EmbedDevIOT/BeekeeperIOT_FreeRTOS/docs/models/images/IMG20220707154456.jpg

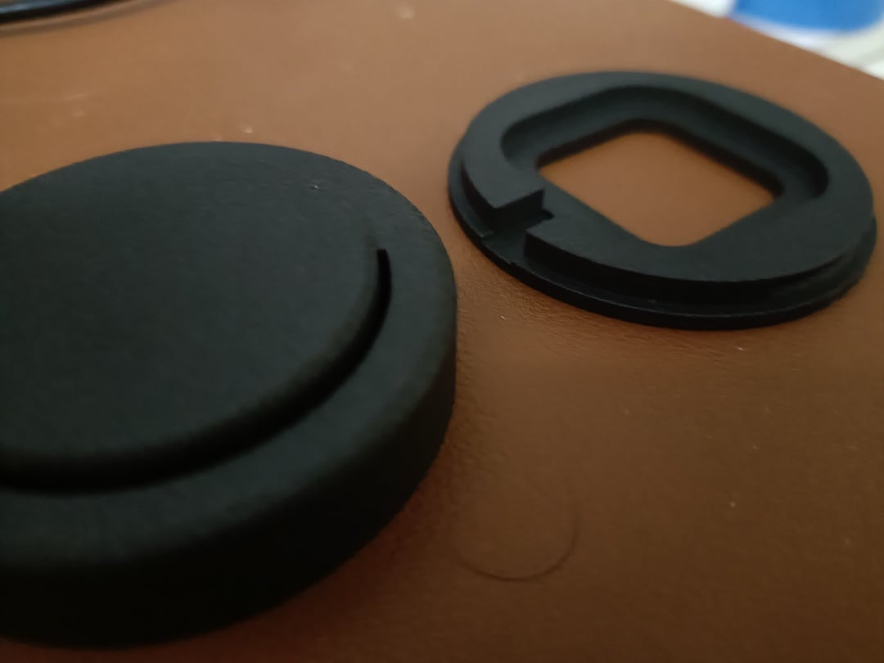
docs/models/images/IMG20220707154456.jpg
