EmbedDevIOT/BeekeeperIOT_FreeRTOS/docs/models/images/IMG20220707154601.jpg

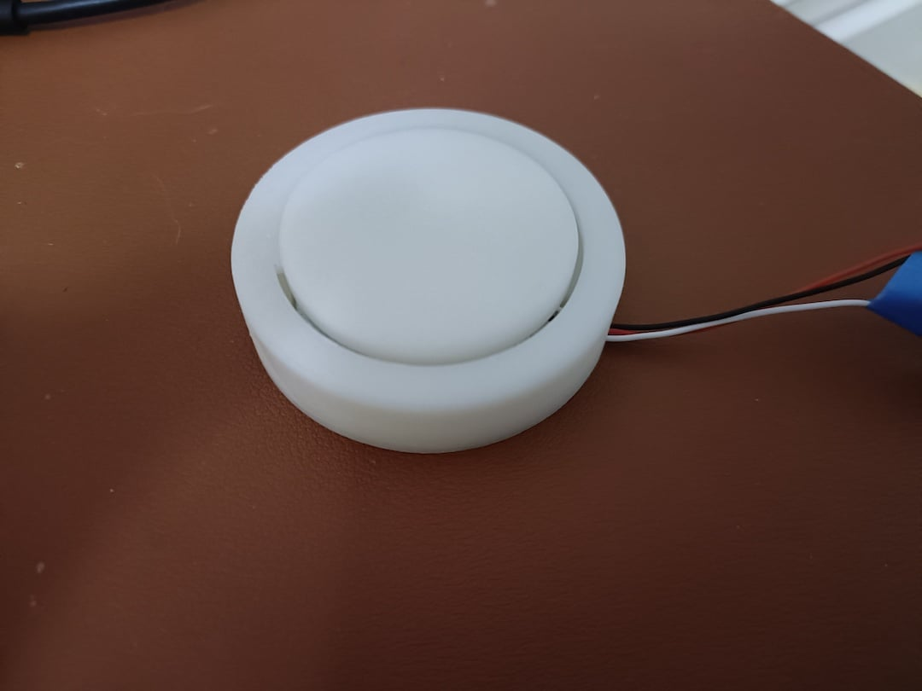
docs/models/images/IMG20220707154601.jpg
