EmbedDevIOT/BeekeeperIOT_FreeRTOS/docs/models/images/CleanShot_2022-07-07_at_15.52.22.png

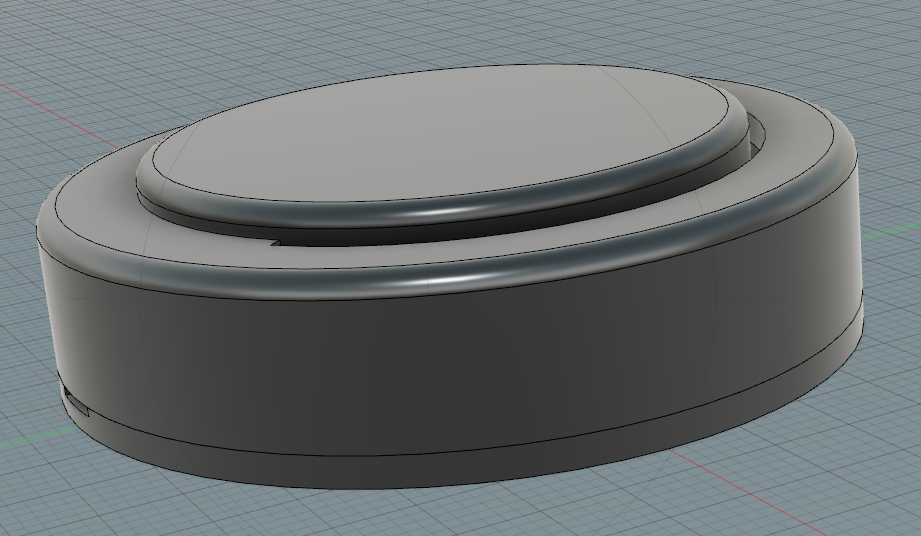
docs/models/images/CleanShot_2022-07-07_at_15.52.22.png
