EmbedDevIOT/BeekeeperIOT_FreeRTOS/docs/models/images/IMG20220707154351.jpg

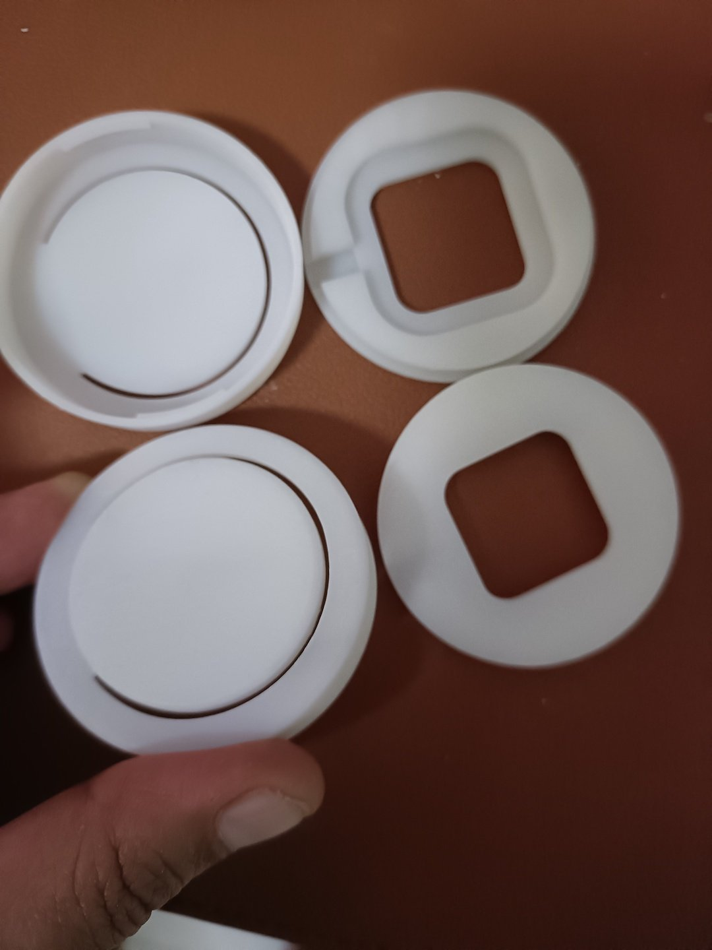
docs/models/images/IMG20220707154351.jpg
