EmbedDevIOT/BeekeeperIOT_FreeRTOS/docs/models/images/IMG20220707154938.jpg

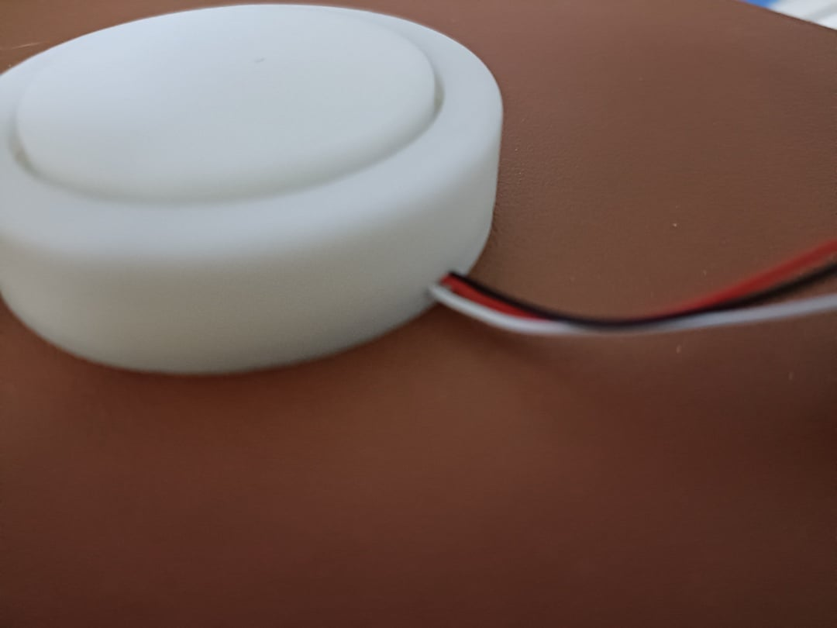
docs/models/images/IMG20220707154938.jpg
