EmbedDevIOT/BeekeeperIOT_FreeRTOS/docs/models/images/IMG20220707161415.jpg

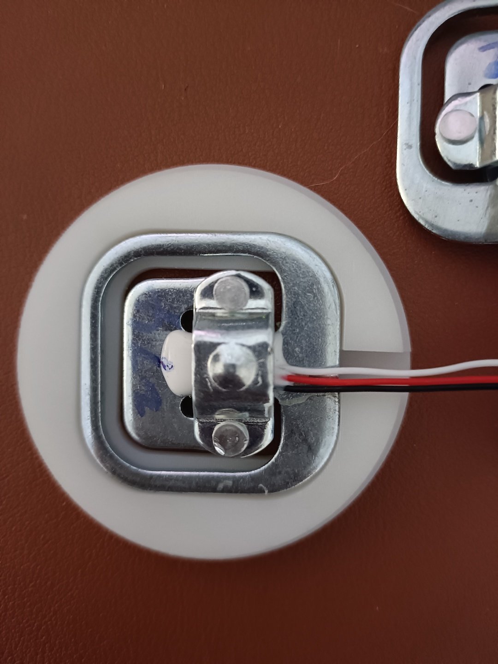
docs/models/images/IMG20220707161415.jpg
