EmbedDevIOT/BeekeeperIOT_FreeRTOS/docs/models/images/LoadCellBaseV3.png

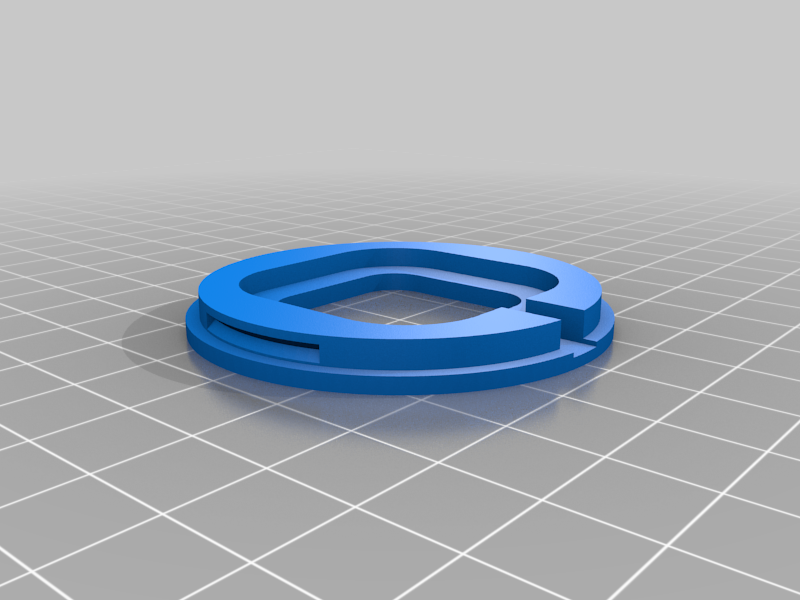
docs/models/images/LoadCellBaseV3.png
