EmbedDevIOT/BeekeeperIOT_FreeRTOS/docs/models/images/LoadCellTopV3.png

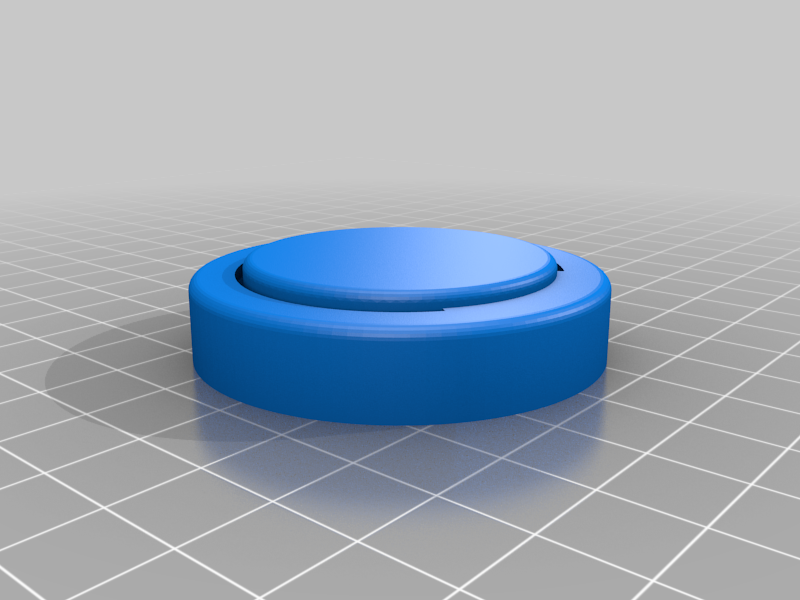
docs/models/images/LoadCellTopV3.png
