EmbedDevIOT/BeekeeperIOT_FreeRTOS/docs/models/files/LPG_Load_Cell_v10.step

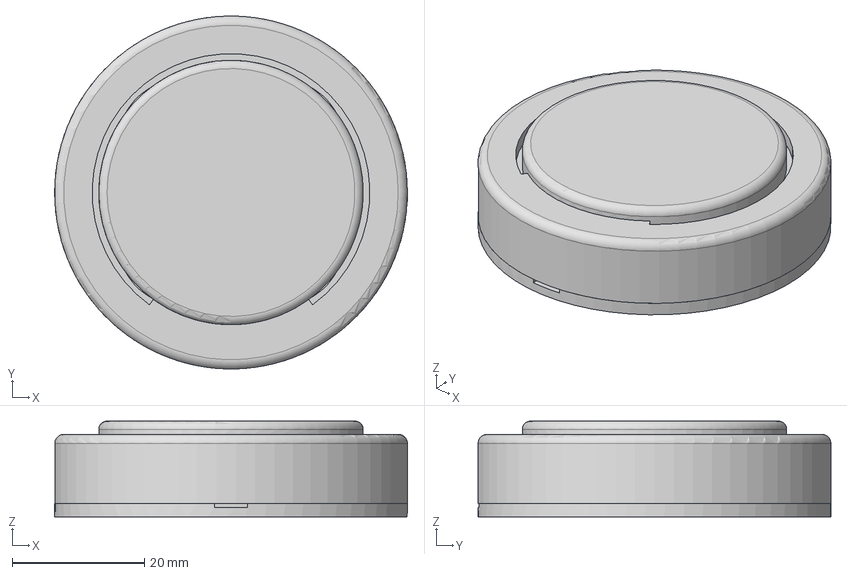
[picture p10: CAD file, 2024-11-13]
docs/models/files/LPG_Load_Cell_v10.step
53.4 x 53.4 x 14.5 mm
BASE, 50 kg Load Cell Resistance Strain Half Bridge Sensor
FLANGED TOP, 50 kg Load Cell Resistance Strain Half Bridge Sensor
SIDE RIVET, 50 kg Load Cell Resistance Strain Half Bridge Sensor
SIDE RIVET, 50 kg Load Cell Resistance Strain Half Bridge Sensor (1)
MIDDLE RIVET, 50 kg Load Cell Resistance Strain Half Bridge Sensor
WIRED CONNECTION, 50 kg Load Cell Resistance Strain Half Bridge Senso r
