EmbedDevIOT/BeekeeperIOT_FreeRTOS/docs/models/files/LoadCellBaseV3.stl

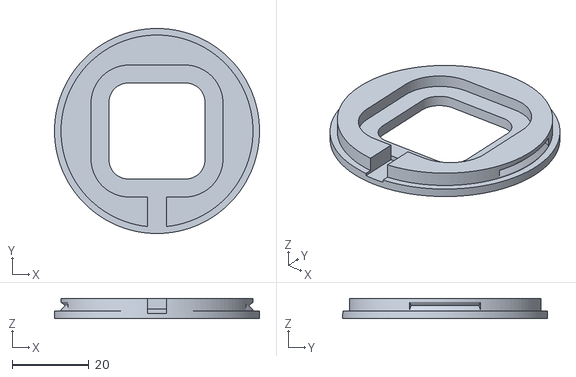
[picture p11: CAD file, 2024-11-13]
docs/models/files/LoadCellBaseV3.stl
53.4 x 53.4 x 5.30
