EmbedDevIOT/BeekeeperIOT_FreeRTOS/docs/models/files/LoadCellTopV3.stl

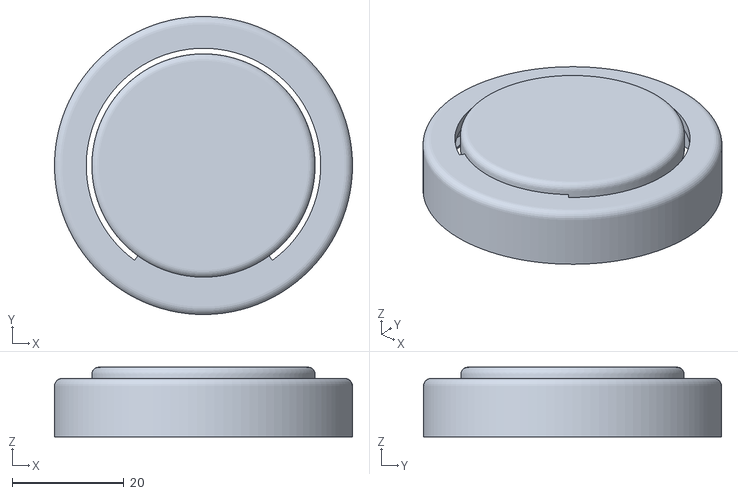
[picture p12: CAD file, 2024-11-13]
docs/models/files/LoadCellTopV3.stl
53.4 x 53.4 x 12.5
