EmbedDevIOT/BeekeeperIOT_FreeRTOS/src/main.cpp

#include "Config.h"

#include "WF.h"
#include "HTTP.h"
#include "sim800.h"

//=======================================================================

//========================== DEFINITIONS ================================
#define uS_TO_S_FACTOR 1000000 /* Conversion factor for micro seconds to seconds */
#define TIME_TO_SLEEP 5        /* Time ESP32 will go to sleep (in seconds) */

#define DISP_TIME (tmrMin == 10 && tmrSec == 0)
#define ITEMS 5 // Main Menu Items
//=======================================================================

//============================== STRUCTURES =============================
// GlobalConfig Config;
GlobalConfig CFG;
SNS sensors;
SYTM System;
DateTime Clock;
Flag ST;
EEP_D _eep;
//=======================================================================

//============================ GLOBAL VARIABLES =========================
uint8_t tim_sec = 0;
uint32_t now;

uint32_t block_timer = 0;

uint16_t tmrSec = 0;
uint16_t tmrMin = 0;
uint8_t disp_ptr = 0;
bool st = false; // menu state ()selection

char charPhoneNumber[11];

RTC_DATA_ATTR int bootCount = 0;
//================================ OBJECTs =============================
#define OLED_SOFT_BUFFER_64 // MCU buffer
GyverOLED<SSD1306_128x64> disp;

HX711 scale;
MicroDS3231 RTC; // 0x68
GyverBME280 bme; // 0x76

Button btUP(PL_PIN, INPUT_PULLUP);
Button btSET(SET_PIN, INPUT_PULLUP);
Button btDWN(MN_PIN, INPUT_PULLUP);
VirtButton btVirt;

// Dallas Themperature sensor DS18b20
OneWire oneWire(DS_SNS);
DallasTemperature ds18b20(&oneWire);

// Freertos Create Task object
TaskHandle_t Task0; // Task pinned to Core 0
TaskHandle_t Task1; // Task pinned to Core 0
TaskHandle_t Task2; // Task pinned to Core 1 (every 500 ms)
TaskHandle_t Task3; // Task pinned to Core 1 (every 1000 ms)
TaskHandle_t Task4; // Task pinned to Core 0 (every 5000 ms)
// FreeRTOS create Mutex link
SemaphoreHandle_t call_mutex;
//=======================================================================

//================================ PROTOTIPs =============================
void StartingInfo(void);
void ButtonHandler(void);
void DisplayHandler(uint8_t item);
void printPointer(uint8_t pointer);
void GetBatVoltage(void);
void GetDSData(void);
void GetBMEData(void);
void GetWeight(void);
void ShowDBG(void);
void Notification(void);

void TaskCore0(void *pvParameters);
void TaskCore1(void *pvParameters);
void Task500ms(void *pvParameters);
void Task1000ms(void *pvParameters);
void Task5s(void *pvParameters);
//=======================================================================

//=======================================================================
// Core 0
void TaskCore0(void *pvParameters)
{
  Serial.print("Task1 running on core ");
  Serial.println(xPortGetCoreID());

  for (;;)
  {
    if (!ST.Call_Block)
    {
      GetWeight();
    }
    vTaskDelay(500 / portTICK_RATE_MS);
  }
}

// Core 0
void TaskCore1(void *pvParameters)
{
  Serial.print("Task2 running on core ");
  Serial.println(xPortGetCoreID());
  for (;;)
  {
    if (block_timer != 20)
    {
      if (!ST.Call_Block)
        ButtonHandler();
    }
    vTaskDelay(100 / portTICK_PERIOD_MS);
  }
}

// Core 1 | Every 500ms Read RTC Data and Notification
void Task500ms(void *pvParameters)
{
  Serial.print("Task500ms running on core ");
  Serial.println(xPortGetCoreID());
  while (true)
  {
    if (block_timer != 20)
    {
      // xSemaphoreTake(call_mutex, portMAX_DELAY);
      IncommingRing();
      Notification();
      Clock = RTC.getTime();
      // xSemaphoreTake(call_mutex, portMAX_DELAY);
    }

    vTaskDelay(500 / portTICK_RATE_MS);
  }
}

// Task every 1000ms (Get Voltage and Show Debug info)
void Task1000ms(void *pvParameters)
{
  Serial.print("Task1000 running on core ");
  Serial.println(xPortGetCoreID());
  while (1)
  {
    if (block_timer != 20)
    {
      // 1 Min Timer
      if (tim_sec < 59)
        tim_sec++;
      else
      {
        tim_sec = 0;
        block_timer++;
        if (!ST.Call_Block)
        {
          GetLevel();
        }
      }

      if (System.DispState)
      {
        DisplayHandler(System.DispMenu);

        if (tmrSec < 59)
        {
          tmrSec++;
        }
        else
        {
          tmrSec = 0;
          tmrMin++;
        }
      }
      else
        disp.setPower(false);

      if DISP_TIME
      {
        System.DispState = false;
        Serial.println("TimeOut: Display - OFF");
        tmrMin = 0;
        tmrSec = 0;
        disp_ptr = 0;
      }

#ifdef DEBUG
      if (!ST.Call_Block)
      {
        // xSemaphoreTake(uart_mutex, portMAX_DELAY);
        ShowDBG();
        // xSemaphoreGive(uart_mutex);
      }
#endif
    }
    else
    {
      disp.setPower(false);
      Serial.println("TimeOut: Trial Version Tim block: ");
    }

    vTaskDelay(1000 / portTICK_PERIOD_MS);
  }
}

void Task5s(void *pvParametrs)
{
  while (1)
  {
    if (!ST.Call_Block)
    {
      GetBatVoltage();
      GetBMEData();
      GetDSData();
    }
    vTaskDelay(5000 / portTICK_PERIOD_MS);
  }
}

//========================================================================
/*
Reading Calibration data from EEPROM. Calibration metodic
* Calibration State
* Calibration factor HX711
* First Start Flag
* Container weight.
*/
void EEPROM_Init()
{
  // ADRs: 0 - Calibration 4 - State_Calibration (Done or False) 5 - FirstStart State
  EEPROM.begin(100);

  disp.setScale(2);
  disp.setCursor(13, 3);
  disp.print("Загрузка");
  disp.update();

  Serial.print("EEPROM: CalibST: ");
  EEPROM.get(0, _eep);
  Serial.printf("ST_Cal: %d \r\n", _eep.st_cal);

  // Сalibration (entred to press set button)
  now = millis();
  while (millis() - now < 2000)
  {
    btSET.tick();
    if (btSET.press())
    {
      Serial.println(F("User cancel. Loading Default preset"));
      _eep.st_cal = CALL_FAIL;
    }
  }

  // Если Весы не откалиброваны
  if (_eep.st_cal != EEP_DONE)
  {
    Serial.println(F("Set Default Preset"));
    _eep.st_cal = 200;
    // _eep.cal_f = -0.830;
    _eep.cal_f = -0.77;
    _eep.avr = -270985;
    // _eep.cal_f = 0.824;
    // _eep.avr = -54200;
    _eep.num[10] = {0};
    _eep.t1_sms = 9;
    _eep.t2_sms = 18;

    EEPROM.put(0, _eep);
    EEPROM.commit();

    delay(100);
    Serial.println(F("DONE"));
  }

  Serial.printf("ST_CAL: %d \r\n", _eep.st_cal);
  Serial.printf("CAL_EEP: %f \r\n", _eep.cal_f);
  Serial.printf("AVR: %d \r\n", _eep.avr);
  delay(500);

  sensors.calib = _eep.cal_f;
  sensors.averange = _eep.avr;
  CFG.UserSendTime1 = _eep.t1_sms;
  CFG.UserSendTime2 = _eep.t2_sms;

  // Reading Time SMS Notifications
  if (CFG.UserSendTime1 == -1)
  {
    CFG.UserSendTime1 = 9;
  }
  Serial.printf("EEPROM: SMS_1: %02d \r\n", CFG.UserSendTime1);

  if (CFG.UserSendTime2 == -1)
  {
    CFG.UserSendTime2 = 20;
  }
  Serial.printf("EEPROM: SMS_2: %02d \r\n", CFG.UserSendTime2);

  // protect to 255 or negative value
  for (uint8_t i = 0; i < 10; i++)
  {
    if (_eep.num[i] > 9 || _eep.num[i] < 0)
    {
      _eep.num[i] = 0;
    }
  }
  // Set string User Phone Number
  for (int i = 0; i < 10; i++)
  {
    charPhoneNumber[i] = (char)(_eep.num[i] + '0');
  }
  CFG.phone += '+';
  CFG.phone += CFG.iso_code;
  CFG.phone += charPhoneNumber;
  Serial.print("EEPROM: Phone: ");
  Serial.println(CFG.phone);

  Serial.println(F("EEPROM_INIT_Done.."));
}
//=======================================================================

//=======================================================================
void StartingInfo()
{
  char msg[32];
  disp.clear(); 

  disp.setScale(2); // масштаб текста (1..4)
  disp.setCursor(10, 3);
  sprintf(msg, "Beekeeper");
  disp.print(msg);
  Serial.println(msg);

  disp.setScale(1);
  disp.setCursor(20, 7);
  sprintf(msg, "firmware:%s", CFG.fw);
  disp.print(msg);
  Serial.println(msg);

  disp.update();
  vTaskDelay(1000 / portTICK_PERIOD_MS);

  disp.clear();
}
//=======================================================================

//=======================       SETUP     ===============================
void setup()
{
  CFG.fw = "1.0.0";
  CFG.fwdate = "13.11.24";
  // UART Init
  Serial.begin(UARTSpeed);
  Serial1.begin(MODEMSpeed);
  // OLED INIT
  Wire.begin();
  disp.init();
  disp.setContrast(255);
  disp.clear();
  Serial.println(F("OLED...Done"));
  // Show starting info
  StartingInfo();
  // RTC INIT
  RTC.begin();
  // RTC battery crash
  if (RTC.lostPower())
  {
    RTC.setTime(COMPILE_TIME);
  }
  Clock = RTC.getTime();
  Serial.println(F("RTC...Done"));

  // SPIFFS
  if (!SPIFFS.begin(true))
  {
    Serial.println("An Error has occurred while mounting SPIFFS");
    return;
  }
  LoadConfig();         // Load configuration from config.json files
  ShowLoadJSONConfig(); // Show load configuration

  // Set Serial Number
  if (SerialNumConfig())
    SaveConfig();

  // EEPROM Init
  EEPROM_Init();

  // HX711 Init
  scale.begin(HX_DT, HX_CLK);
  scale.set_scale();
  scale.set_offset(sensors.averange);
  Serial.println(F("HX711 init done"));

  // BME and DS SENSOR INIT
  bme.begin(0x76);
  Serial.println(F("BME...Done"));
  ds18b20.begin();
  Serial.println(F("DS18b20...Done"));
  vTaskDelay(20 / portTICK_PERIOD_MS);
  // Battery pin init
  pinMode(BAT, INPUT);
  Serial.println(F("Battery Init...Done"));
  // SIM800 INIT
  vTaskDelay(1000 / portTICK_PERIOD_MS);
  sim800_init(9600, 16, 17);
  sim800_conf();
  Serial.println(F("SIM800 Init...Done"));
  disp.clear();

  GetBatVoltage();
  GetBMEData();
  GetDSData();
  GetWeight();
  GetLevel();

  Serial.println("Wifi init");
  WIFIinit();
  vTaskDelay(500 / portTICK_PERIOD_MS);
  Serial.println("Wifi Enable");

  HTTPinit(); // HTTP server initialisation
  vTaskDelay(500 / portTICK_PERIOD_MS);

  disp.update();

  call_mutex = xSemaphoreCreateMutex();
  // Create Task. Running to core 0
  xTaskCreatePinnedToCore(
      TaskCore0, // Функция для задачи
      "Task0",   // Имя задачи
      10000,     // Размер стека
      NULL,      // Параметр задачи
      1,         // Приоритет
      &Task0,    // Выполняемая операция
      0          // Номер ядра
  );
  delay(100);

  // Create Task. Running to core 1
  xTaskCreatePinnedToCore(
      TaskCore1,
      "Task1",
      12228,
      NULL,
      1,
      &Task1,
      0);
  delay(100);

  xTaskCreatePinnedToCore(
      Task500ms,
      "Task2",
      2048,
      NULL,
      1,
      &Task2,
      1);
  delay(100);

  xTaskCreatePinnedToCore(
      Task1000ms,
      "Task3",
      2048,
      NULL,
      1,
      &Task3,
      1);

  xTaskCreatePinnedToCore(
      Task5s,
      "Task4",
      2048,
      NULL,
      1,
      &Task4,
      0);

  Serial.println(F("FreeRTOS started...Done"));
}

//=========================      M A I N       ===========================
void loop() {}
//========================================================================

//========================================================================
void Notification()
{
  char buf[128] = "";
  if (ST.SMS1 && Clock.hour == Config.UserSendTime1 && Clock.minute == 30 && Clock.second == 0)
  {
    Serial.println("Send Notification: SMS1");
    ST.Call_Block = true;
    SendUserSMS();

    delay(200);

    ST.SMS1 = false;
    ST.SMS2 = true;
    ST.Call_Block = false;
  }

  if (ST.SMS2 && Clock.hour == Config.UserSendTime2 && Clock.minute == 0 && Clock.second == 0)
  {
    Serial.println("Send Notification: SMS2");
    ST.Call_Block = true;

    SendUserSMS();

    delay(200);
    ST.SMS1 = true;
    ST.SMS2 = false;
    ST.Call_Block = false;
  }
}
//========================================================================

//========================================================================
void ButtonHandler()
{
  btSET.tick();
  btUP.tick();
  btDWN.tick();
  btVirt.tick(btUP, btDWN);

  if (btSET.click())
  {
    Serial.println("Btn SET click");
    if (System.DispMenu == Action)
    {
      System.DispMenu = Menu;
    }

    if (System.DispState == true)
    {
      if (System.DispMenu == Menu && disp_ptr == 0)
      {
        if (!st)
        {
          System.DispMenu = Menu;
          Serial.println("General Menu:");
          disp.clear();
          disp.home();
          disp.setScale(1);
          disp.print(F(
              "  Время:\r\n"
              "  Калибровка:\r\n"
              "  Оповещения:\r\n"
              // "  Аккумулятор:\r\n"
              "  Номер СМС:\r\n"
              "  Выход:\r\n"));

          printPointer(disp_ptr); // Show pointer
          disp.update();
          st = true;
        }
        else
        {
          System.DispMenu = Time;
          Serial.println("Time Menu:");
          st = false;
        }
      }

      if (System.DispMenu == Menu && disp_ptr == 1)
      {
        System.DispMenu = Calib;
        Serial.println("Calibration Menu:");
      }

      if (System.DispMenu == Menu && disp_ptr == 2)
      {
        System.DispMenu = Notifycation;
        Serial.println("Notifycation menu:");
      }

      if (System.DispMenu == Menu && disp_ptr == 3)
      {
        System.DispMenu = SMS_NUM;
        Serial.println("SMS Number:");
      }

      if (System.DispMenu == Menu && disp_ptr == 4)
      {
        Serial.println("Exit");

        System.DispMenu = Action;
        disp_ptr = 0;
        st = false;
      }
    }
    else // enable display
    {
      disp.setPower(true);
      System.DispMenu = Action;
      System.DispState = true;
    }

    tmrMin = 0;
    tmrSec = 0;
    disp.clear();
  }

  if (btUP.click() || btUP.hold())
  {
    Serial.println("Btn UP click");
    tmrMin = 0;
    tmrSec = 0;

    if (System.DispMenu == Menu)
      disp_ptr = constrain(disp_ptr + 1, 0, ITEMS - 1);

    sensors.calib += 0.01;
    _eep.cal_f = sensors.calib;

    Serial.printf("C:%0.4f \r\n", sensors.calib);

    // Serial.printf("ptr:%d \r\n", disp_ptr);
    Serial.println();
  }

  if (btVirt.click() && System.DispMenu == Action)
  {
    Serial.println("Set zero");
    System.DispMenu = ZeroSet;
  }

  if (btDWN.click() || btDWN.hold())
  {
    Serial.println("Btn DWN click");
    tmrMin = 0;
    tmrSec = 0;

    if (System.DispMenu == Menu)
      disp_ptr = constrain(disp_ptr - 1, 0, ITEMS - 1);

    sensors.calib -= 0.01;
    _eep.cal_f = sensors.calib;

    Serial.printf("C: %0.4f \r\n", sensors.calib);

    // Serial.printf("ptr:%d \r\n", disp_ptr);
  }
}
//========================================================================

//========================================================================
// Get Data from BME Sensor
void GetBMEData()
{
  sensors.bmeT = bme.readTemperature();
  sensors.bmeH = (int)bme.readHumidity() + sensors.bmeHcal;
  sensors.bmeP_hPa = bme.readPressure();
  sensors.bmeP_mmHg = (int)pressureToMmHg(sensors.bmeP_hPa);
}
//========================================================================

//========================================================================
// Get Data from DS18B20 Sensor
void GetDSData()
{
  ds18b20.requestTemperatures();
  sensors.dsT = ds18b20.getTempCByIndex(0);
}
//========================================================================

//========================================================================
// Get Data from HX711
// Every 500 ms
void GetWeight()
{
  scale.set_scale(sensors.calib);
  sensors.units = scale.get_units(5);
  sensors.grms = (sensors.units * 0.035274);
  sensors.kg = float(sensors.grms / 1000);
  sensors.kg = constrain(sensors.kg, 0.0, 200.0);
}
//========================================================================

//========================================================================
void DisplayHandler(uint8_t item)
{
  switch (item)
  {
    char dispbuf[30];
  case Menu:
  {
    disp.clear();
    disp.home();
    disp.setScale(1);
    disp.print(F(
        "  Время:\r\n"
        "  Калибровка:\r\n"
        "  Оповещения:\r\n"
        "  Номер СМС:\r\n"
        "  Выход:\r\n"));

    printPointer(disp_ptr); // Show pointer
    disp.update();
    break;
  }

  case Action:
  {
    sprintf(dispbuf, "%02d:%02d", Clock.hour, Clock.minute);
    disp.setScale(2);
    disp.setCursor(0, 0);
    disp.print(dispbuf);

    disp.setCursor(85, 0);
    if (sensors.voltage == 0)
    {
      sprintf(dispbuf, "---");
    }
    else
      sprintf(dispbuf, "%3d", sensors.voltage);
    disp.print(dispbuf);

    sprintf(dispbuf, "%0.1f", sensors.kg);
    disp.setScale(3);
    disp.setCursor(40, 2);
    disp.print(dispbuf);

    sprintf(dispbuf, "T1:%0.1fC     T2:%0.1fC", sensors.dsT, sensors.bmeT);
    disp.setScale(1);
    disp.setCursor(0, 6);
    disp.print(dispbuf);

    sprintf(dispbuf, "H:%02d            P:%003d", sensors.bmeH, sensors.bmeP_mmHg);
    disp.setCursor(0, 7);
    disp.print(dispbuf);
    disp.update();
    break;
  }

  case Time:
  {
    int8_t _hour = RTC.getHours();
    int8_t _min = RTC.getMinutes();
    bool set = false;

    disp.clear();
    disp.setScale(2);
    disp.setCursor(0, 0);
    disp.print(F(" Установка \r\n"
                 "  времени \r\n"));
    disp.setCursor(35, 5);
    sprintf(dispbuf, "%02d:", _hour);
    disp.print(dispbuf);

    disp.invertText(true);
    sprintf(dispbuf, "%02d", _min);
    disp.print(dispbuf);
    disp.update();

    while (!set)
    {
      bool _setH = false;
      bool _setM = true;

      btSET.tick();
      btUP.tick();
      btDWN.tick();

      // Setting Minute
      while (_setM)
      {
        btSET.tick();
        btUP.tick();
        btDWN.tick();

        if (btUP.click())
        {
          disp.clear();
          disp.setScale(2);
          disp.setCursor(0, 0);
          disp.invertText(false);
          disp.print(F(" Установка \r\n"
                       "  времени \r\n"));
          _min++;
          if (_min > 59)
            _min = 0;

          disp.setCursor(35, 5);
          sprintf(dispbuf, "%02d:", _hour);
          disp.print(dispbuf);

          disp.invertText(true);
          sprintf(dispbuf, "%02d", _min);
          disp.print(dispbuf);
          disp.update();
        }

        if (btDWN.click())
        {
          disp.clear();
          disp.setCursor(0, 0);
          disp.setScale(2);
          disp.invertText(false);
          disp.print(F(" Установка \r\n"
                       "  времени \r\n"));
          _min--;
          if (_min < 0)
            _min = 59;

          disp.setCursor(35, 5);
          sprintf(dispbuf, "%02d:", _hour);
          disp.print(dispbuf);

          disp.invertText(true);
          sprintf(dispbuf, "%02d", _min);
          disp.print(dispbuf);
          disp.update();
        }
        // Exit Set MIN and select Hour set
        if (btSET.click())
        {
          _setM = false;
          _setH = true;
          Serial.println(F("Minute set"));

          disp.clear();
          disp.setScale(2);
          disp.setCursor(0, 0);
          disp.invertText(false);
          disp.print(F(" Установка \r\n"
                       "  времени \r\n"));
          disp.setCursor(35, 5);
          disp.invertText(true);
          sprintf(dispbuf, "%02d", _hour);
          disp.print(dispbuf);

          disp.invertText(false);
          sprintf(dispbuf, ":%02d", _min);
          disp.print(dispbuf);
          disp.update();
        }
      }
      //  HOUR
      while (_setH)
      {
        btSET.tick();
        btUP.tick();
        btDWN.tick();

        if (btUP.click())
        {
          disp.clear();
          disp.setCursor(0, 0);
          disp.setScale(2);
          disp.invertText(false);
          disp.print(F(" Установка \r\n"
                       "  времени \r\n"));
          _hour++;
          if (_hour > 23)
            _hour = 0;

          disp.invertText(true);
          disp.setCursor(35, 5);
          sprintf(dispbuf, "%02d", _hour);
          disp.print(dispbuf);

          disp.invertText(false);
          sprintf(dispbuf, ":%02d", _min);
          disp.print(dispbuf);
          disp.update();
        }

        if (btDWN.click())
        {
          disp.clear();
          disp.setCursor(0, 0);
          disp.setScale(2);
          disp.invertText(false);
          disp.print(F(" Установка \r\n"
                       "  времени \r\n"));
          _hour--;
          if (_hour < 0)
            _hour = 23;

          disp.invertText(true);
          disp.setCursor(35, 5);
          sprintf(dispbuf, "%02d", _hour);
          disp.print(dispbuf);

          disp.invertText(false);
          sprintf(dispbuf, ":%02d", _min);
          disp.print(dispbuf);
          disp.update();
        }
        // Exit Set HOUR and SAVE settings
        if (btSET.click())
        {
          _setM = false; // flag set Min (need to exit)
          _setH = false; // flag set Hour(need to exit)
          set = true;    // flag set Time (need to exit)
          Serial.println(F("HOUR set"));
          RTC.setTime(0, _min, _hour, Clock.date, Clock.month, Clock.year);

          st = false;
          System.DispMenu = Action;
          disp_ptr = 0;

          disp.clear();
          disp.invertText(false);
          disp.setScale(2);
          disp.setCursor(13, 3);
          disp.print("Сохранено");
          disp.update();
          delay(500);
          disp.clear();
        }
      }
    }
    break;
  }

  case Calib:
  {
    disp.clear();
    disp.setScale(2);
    disp.setCursor(0, 0);
    disp.print("Калибровка");
    disp.setCursor(17, 5);
    disp.printf("  %0.2f  ", sensors.kg);
    disp.update();
    // ST.HX711_Block = true;

    while (1)
    {
      btSET.tick();
      btUP.tick();
      btDWN.tick();

      while (btUP.busy())
      {
        btUP.tick();

        if (btUP.click())
        {
          sensors.calib += 0.01;
          _eep.cal_f = sensors.calib;

          Serial.printf("C:%0.4f \r\n", sensors.calib);
          GetWeight();
          Serial.printf("W:%0.2f \r\n", sensors.kg);

          disp.clear();
          disp.setScale(2);
          disp.setCursor(0, 0);
          disp.print("Калибровка");
          disp.setCursor(17, 5);
          disp.printf("  %0.2f  ", sensors.kg);
          disp.update();
        }

        if (btUP.step())
        {
          sensors.calib += 0.1;

          Serial.printf("C:%0.4f \r\n", sensors.calib);
          GetWeight();
          Serial.printf("W:%0.2f \r\n", sensors.kg);

          disp.clear();
          disp.setScale(2);
          disp.setCursor(0, 0);
          disp.print("Калибровка");
          disp.setCursor(17, 5);
          disp.printf("  %0.2f  ", sensors.kg);
          disp.update();
        }
      }

      while (btDWN.busy())
      {
        btDWN.tick();
        if (btDWN.click())
        {
          sensors.calib -= 0.01;
          _eep.cal_f = sensors.calib;

          Serial.printf("C: %0.4f \r\n", sensors.calib);
          GetWeight();
          Serial.printf("W: %0.2f \r\n", sensors.kg);

          disp.clear();
          disp.setScale(2);
          disp.setCursor(0, 0);
          disp.print("Калибровка");
          disp.setCursor(17, 5);
          disp.printf("  %0.2f  ", sensors.kg);
          disp.update();
        }

        if (btDWN.step())
        {
          sensors.calib -= 0.1;

          Serial.printf("C: %0.4f \r\n", sensors.calib);
          GetWeight();
          Serial.printf("W: %0.2f \r\n", sensors.kg);

          disp.clear();
          disp.setScale(2);
          disp.setCursor(0, 0);
          disp.print("Калибровка");
          disp.setCursor(17, 5);
          disp.printf("  %0.2f  ", sensors.kg);
          disp.update();
        }
      }

      // Exit Set CAlibration and SAVE settings
      if (btSET.click())
      {
        EEPROM.put(0, _eep);
        EEPROM.commit();

        Serial.println(F("EEPROM: Calibration SAVE"));

        System.DispMenu = Action;
        disp_ptr = 0;
        st = false;

        disp.clear();
        disp.setScale(2);
        disp.setCursor(13, 3);
        disp.print("Сохранено");
        disp.update();
        delay(500);
        disp.clear();
        // ST.HX711_Block = false;
        return;
      }
    }
    break;
  }

  case Notifycation:
  {
    disp.clear();
    disp.invertText(false);
    disp.setScale(2);
    disp.setCursor(13, 0);
    disp.print("Время СМС");
    disp.setCursor(25, 3);
    disp.invertText(true);
    disp.printf("SMS1:%d", Config.UserSendTime1);
    disp.invertText(false);
    disp.setCursor(25, 5);
    disp.printf("SMS2:%d", Config.UserSendTime2);
    disp.update();

    bool _setSMS1 = true;
    bool _setSMS2 = false;
    // Set SMS_1
    while (_setSMS1)
    {
      btSET.tick();
      btUP.tick();
      btDWN.tick();

      if (btUP.click())
      {
        Config.UserSendTime1++;

        if (Config.UserSendTime1 > 23)
        {
          Config.UserSendTime1 = 0;
        }

        disp.clear();
        disp.invertText(false);
        disp.setScale(2);
        disp.setCursor(13, 0);
        disp.print("Время СМС");
        disp.setCursor(25, 3);
        disp.invertText(true);
        disp.printf("SMS1:%d", Config.UserSendTime1);
        disp.setCursor(25, 5);
        disp.invertText(false);
        disp.printf("SMS2:%d", Config.UserSendTime2);
        disp.update();
      }

      if (btDWN.click())
      {
        Config.UserSendTime1--;

        if (Config.UserSendTime1 < 0)
        {
          Config.UserSendTime1 = 23;
        }

        disp.clear();
        disp.invertText(false);
        disp.setScale(2);
        disp.setCursor(13, 0);
        disp.print("Время СМС");
        disp.setCursor(25, 3);
        disp.invertText(true);
        disp.printf("SMS1:%d", Config.UserSendTime1);
        disp.setCursor(25, 5);
        disp.invertText(false);
        disp.printf("SMS2:%d", Config.UserSendTime2);
        disp.update();
      }

      // Exit Set Calibration and SAVE settings
      if (btSET.click())
      {
        _eep.t1_sms = Config.UserSendTime1;
        EEPROM.put(0, _eep);
        EEPROM.commit();

        Serial.println(F("EEPROM: SMS_1_MSG SAVE"));

        disp.clear();
        disp.invertText(false);
        disp.setScale(2);
        disp.setCursor(13, 0);
        disp.print("Время СМС");
        disp.setCursor(25, 3);
        disp.invertText(false);
        disp.printf("SMS1:%d", Config.UserSendTime1);
        disp.setCursor(25, 5);
        disp.invertText(true);
        disp.printf("SMS2:%d", Config.UserSendTime2);
        disp.update();

        _setSMS1 = false; // flag to EXIT
        _setSMS2 = true;  // flag to enter in set SMS2
      }
    }
    // Set SMS_2
    while (_setSMS2)
    {
      btSET.tick();
      btUP.tick();
      btDWN.tick();

      if (btUP.click())
      {
        Config.UserSendTime2++;

        if (Config.UserSendTime2 > 23)
        {
          Config.UserSendTime2 = 0;
        }

        disp.clear();
        disp.invertText(false);
        disp.setScale(2);
        disp.setCursor(13, 0);
        disp.print("Время СМС");
        disp.setCursor(25, 3);
        disp.printf("SMS1:%d", Config.UserSendTime1);
        disp.invertText(true);
        disp.setCursor(25, 5);
        disp.printf("SMS2:%d", Config.UserSendTime2);
        disp.update();
      }

      if (btDWN.click())
      {
        Config.UserSendTime2--;
        if (Config.UserSendTime2 < 0)
        {
          Config.UserSendTime2 = 23;
        }

        disp.clear();
        disp.invertText(false);
        disp.setScale(2);
        disp.setCursor(13, 0);
        disp.print("Время СМС");
        disp.setCursor(25, 3);
        disp.printf("SMS1:%d", Config.UserSendTime1);
        disp.invertText(true);
        disp.setCursor(25, 5);
        disp.printf("SMS2:%d", Config.UserSendTime2);
        disp.update();
      }

      // Exit Set Calibration and SAVE settings
      if (btSET.click())
      {
        _eep.t2_sms = Config.UserSendTime2;
        EEPROM.put(0, _eep);
        EEPROM.commit();

        Serial.println(F("EEPROM: SMS_2_MSG SAVE"));

        System.DispMenu = Action;
        disp_ptr = 0;
        st = false;

        disp.invertText(false);

        disp.clear();

        disp.clear();
        disp.setScale(2);
        disp.setCursor(13, 3);
        disp.print("Сохранено");
        disp.update();
        delay(500);
        disp.clear();
        _setSMS1 = false; // flag to EXIT
        _setSMS2 = false; // flag to EXIT
      }
    }
    break;
  }

  case SMS_NUM:
  {
    int currentDigit = 0;

    disp.clear();
    disp.setScale(2);
    disp.setCursor(0, 0);
    disp.print("СМС Номер:");

    disp.setCursor(0, 5);
    for (int i = 0; i < 10; i++)
    {
      if (i == currentDigit)
      {
        disp.invertText(true);
      }
      else
        disp.invertText(false);
      disp.print(_eep.num[i]);
    }

    disp.update();

    while (currentDigit != 10)
    {
      btSET.tick();
      btUP.tick();
      btDWN.tick();

      if (btUP.click())
      {
        _eep.num[currentDigit] = (_eep.num[currentDigit] + 1) % 10;

        disp.clear();
        disp.setScale(2);
        disp.invertText(false);
        disp.setCursor(0, 0);
        disp.print("СМС Номер:");

        disp.setCursor(0, 5);
        for (int i = 0; i < 10; i++)
        {
          (i == currentDigit) ? disp.invertText(true) : disp.invertText(false);
          disp.print(_eep.num[i]);
        }
        disp.update();
      }

      if (btDWN.click())
      {
        _eep.num[currentDigit] = (_eep.num[currentDigit] - 1 + 10) % 10;

        disp.clear();
        disp.setScale(2);
        disp.invertText(false);
        disp.setCursor(0, 0);
        disp.print("СМС Номер:");

        disp.setCursor(0, 5);
        for (int i = 0; i < 10; i++)
        {
          (i == currentDigit) ? disp.invertText(true) : disp.invertText(false);
          disp.print(_eep.num[i]);
        }
        disp.update();
      }

      // Exit Set CAlibration and SAVE settings
      if (btSET.click())
      {
        currentDigit++;

        Serial.printf("Current Digit: %d", currentDigit);
        Serial.println();

        disp.clear();
        disp.setScale(2);
        disp.invertText(false);
        disp.setCursor(0, 0);
        disp.print("СМС Номер:");

        disp.setCursor(0, 5);
        for (int i = 0; i < 10; i++)
        {
          (i == currentDigit) ? disp.invertText(true) : disp.invertText(false);
          disp.print(_eep.num[i]);
        }
        disp.update();
      }
    }

    for (int i = 0; i < 10; i++)
    {
      charPhoneNumber[i] = (char)(_eep.num[i] + '0');
    }

    EEPROM.put(0, _eep);
    EEPROM.commit();

    Config.phone.clear(); // Clear String
    Config.phone += '+';
    Config.phone += Config.iso_code;
    Config.phone += charPhoneNumber;

    Serial.printf("EEPROM: SMS Number: %s", Config.phone);
    Serial.println();

    System.DispMenu = Action;
    disp_ptr = 0;
    st = false;

    disp.clear();
    disp.setScale(2);
    disp.setCursor(13, 3);
    disp.invertText(false);
    disp.print("Сохранено");
    disp.update();
    delay(500);
    disp.clear();
    break;
  }

  case ZeroSet:
  {
    char msg[50];
    ST.HX711_Block = true;
    disp.clear();
    disp.setScale(2);
    disp.setCursor(0, 1);
    disp.print(F(
        " Установка \r\n"
        "   нуля \r\n"
        " подождите..  \r\n"));
    disp.update();

    sensors.averange = scale.read_average();
    _eep.avr = sensors.averange;
    Serial.printf("Averange: %d \r\n", sensors.averange);
    scale.set_offset(sensors.averange);

    EEPROM.put(0, _eep);
    EEPROM.commit();
    vTaskDelay(1000 / portTICK_PERIOD_MS);

    ST.HX711_Block = false; // block task0;
    st = false;
    System.DispMenu = Action;
    disp_ptr = 0;

    disp.clear();
    break;
  }

  default:
    break;
  }
}
//========================================================================

//========================================================================
void printPointer(uint8_t pointer)
{
  disp.setCursor(0, pointer);
  disp.print(">");
  // disp.update();
}
//========================================================================

//========================================================================
void GetBatVoltage(void)
{
  uint32_t _mv = 0;
  // 12.82 - 1195
  // 10.8  - 1010
  const uint16_t min = 1010, max = 1195;
  // 1250 = 10.8
  // 1380 = 12.82
  // const uint16_t min = 1250, max = 1390;

  for (uint8_t i = 0; i < 12; i++)
  {
    _mv += analogReadMilliVolts(BAT);
  }
  _mv = _mv / 12;

  // Serial.println(_mv);

  if (_mv == 0 || _mv < min)
  {
    _mv = 0;
  }
  else if (_mv >= min && _mv <= max)
  {
    _mv = map(_mv, min, max, 10, 100);
  }
  else if (_mv > max)
  {
    _mv = max;
    _mv = map(_mv, min, max, 10, 100);
  }
  sensors.voltage = _mv;
}
//========================================================================

//========================================================================
void ShowDBG()
{
  char message[52];

  Serial.println(F("!!!!!!!!!!!!!!  DEBUG INFO  !!!!!!!!!!!!!!!!!!"));

  // sprintf(message, "DISP:%d | ML %d | P: %d T: %02d:%02d ", System.DispState, System.DispMenu, disp_ptr, tmrMin, tmrSec);
  // Serial.println(message);

  // sprintf(message, "TimeRTC: %02d:%02d:%02d", Clock.hour, Clock.minute, Clock.second);
  // Serial.println(message);
  // sprintf(message, "T_DS:%0.2f *C", sensors.dsT);
  // Serial.println(message);
  // sprintf(message, "T_BME:%0.2f *C | H_BME:%0d % | P_BHE:%d", sensors.bmeT, (int)sensors.bmeH, (int)sensors.bmeP_mmHg);
  // Serial.println(message);
  sprintf(message, "WEIGHT: %0.2fg | CAL: %0.5f  | W_AVR: %0d", sensors.kg, sensors.calib, sensors.averange);
  Serial.println(message);
  // sprintf(message, "BAT: %003d", sensors.voltage);
  // Serial.println(message);
  // sprintf(message, "SIM800 Signal: %d", sensors.signal);
  // Serial.println(message);
  // sprintf(message, "EEPROM: SMS_1 %02d | SMS_2 %02d", Config.UserSendTime1, Config.UserSendTime2);
  // Serial.println(message);

  // sprintf(message, "EEPROM: Phone: %s", Config.phone);
  // Serial.println(message);
  // sprintf(message, "Block Timer: %d", block_timer);
  // Serial.println(message);

  Serial.println(F("!!!!!!!!!!!!!!!!!!!!!!!!!!!!!!!!!!!!!!!!!!!!!!"));
  Serial.println();
}

/* Method to print the reason by which ESP32
has been awaken from sleep
*/
void print_wakeup_reason()
{
  esp_sleep_wakeup_cause_t wakeup_reason;

  wakeup_reason = esp_sleep_get_wakeup_cause();

  switch (wakeup_reason)
  {
  case ESP_SLEEP_WAKEUP_EXT0:
    Serial.println("Wakeup caused by external signal using RTC_IO");
    break;
  case ESP_SLEEP_WAKEUP_EXT1:
    Serial.println("Wakeup caused by external signal using RTC_CNTL");
    break;
  case ESP_SLEEP_WAKEUP_TIMER:
    Serial.println("Wakeup caused by timer");
    break;
  case ESP_SLEEP_WAKEUP_TOUCHPAD:
    Serial.println("Wakeup caused by touchpad");
    break;
  case ESP_SLEEP_WAKEUP_ULP:
    Serial.println("Wakeup caused by ULP program");
    break;
  default:
    Serial.printf("Wakeup was not caused by deep sleep: %d\n", wakeup_reason);
    break;
  }
}
