EmbedDevIOT/BeekeeperIOT_FreeRTOS/(commit log)

2024-03-24 v.0.9.8 24.03.24 timing upd_sms data fix
    [main.cpp]
2024-11-13 wifi_gui/start <0.1>
    [LPG_Load_Cell_v10.step, LoadCellBaseV3.stl, LoadCellTopV3.stl]
